bgkendall/piantor-remix/pcb/left/keyboard_pcb.kicad_pcb

## KiCad design pcb/left/keyboard_pcb.kicad_pcb (2024-06-12)

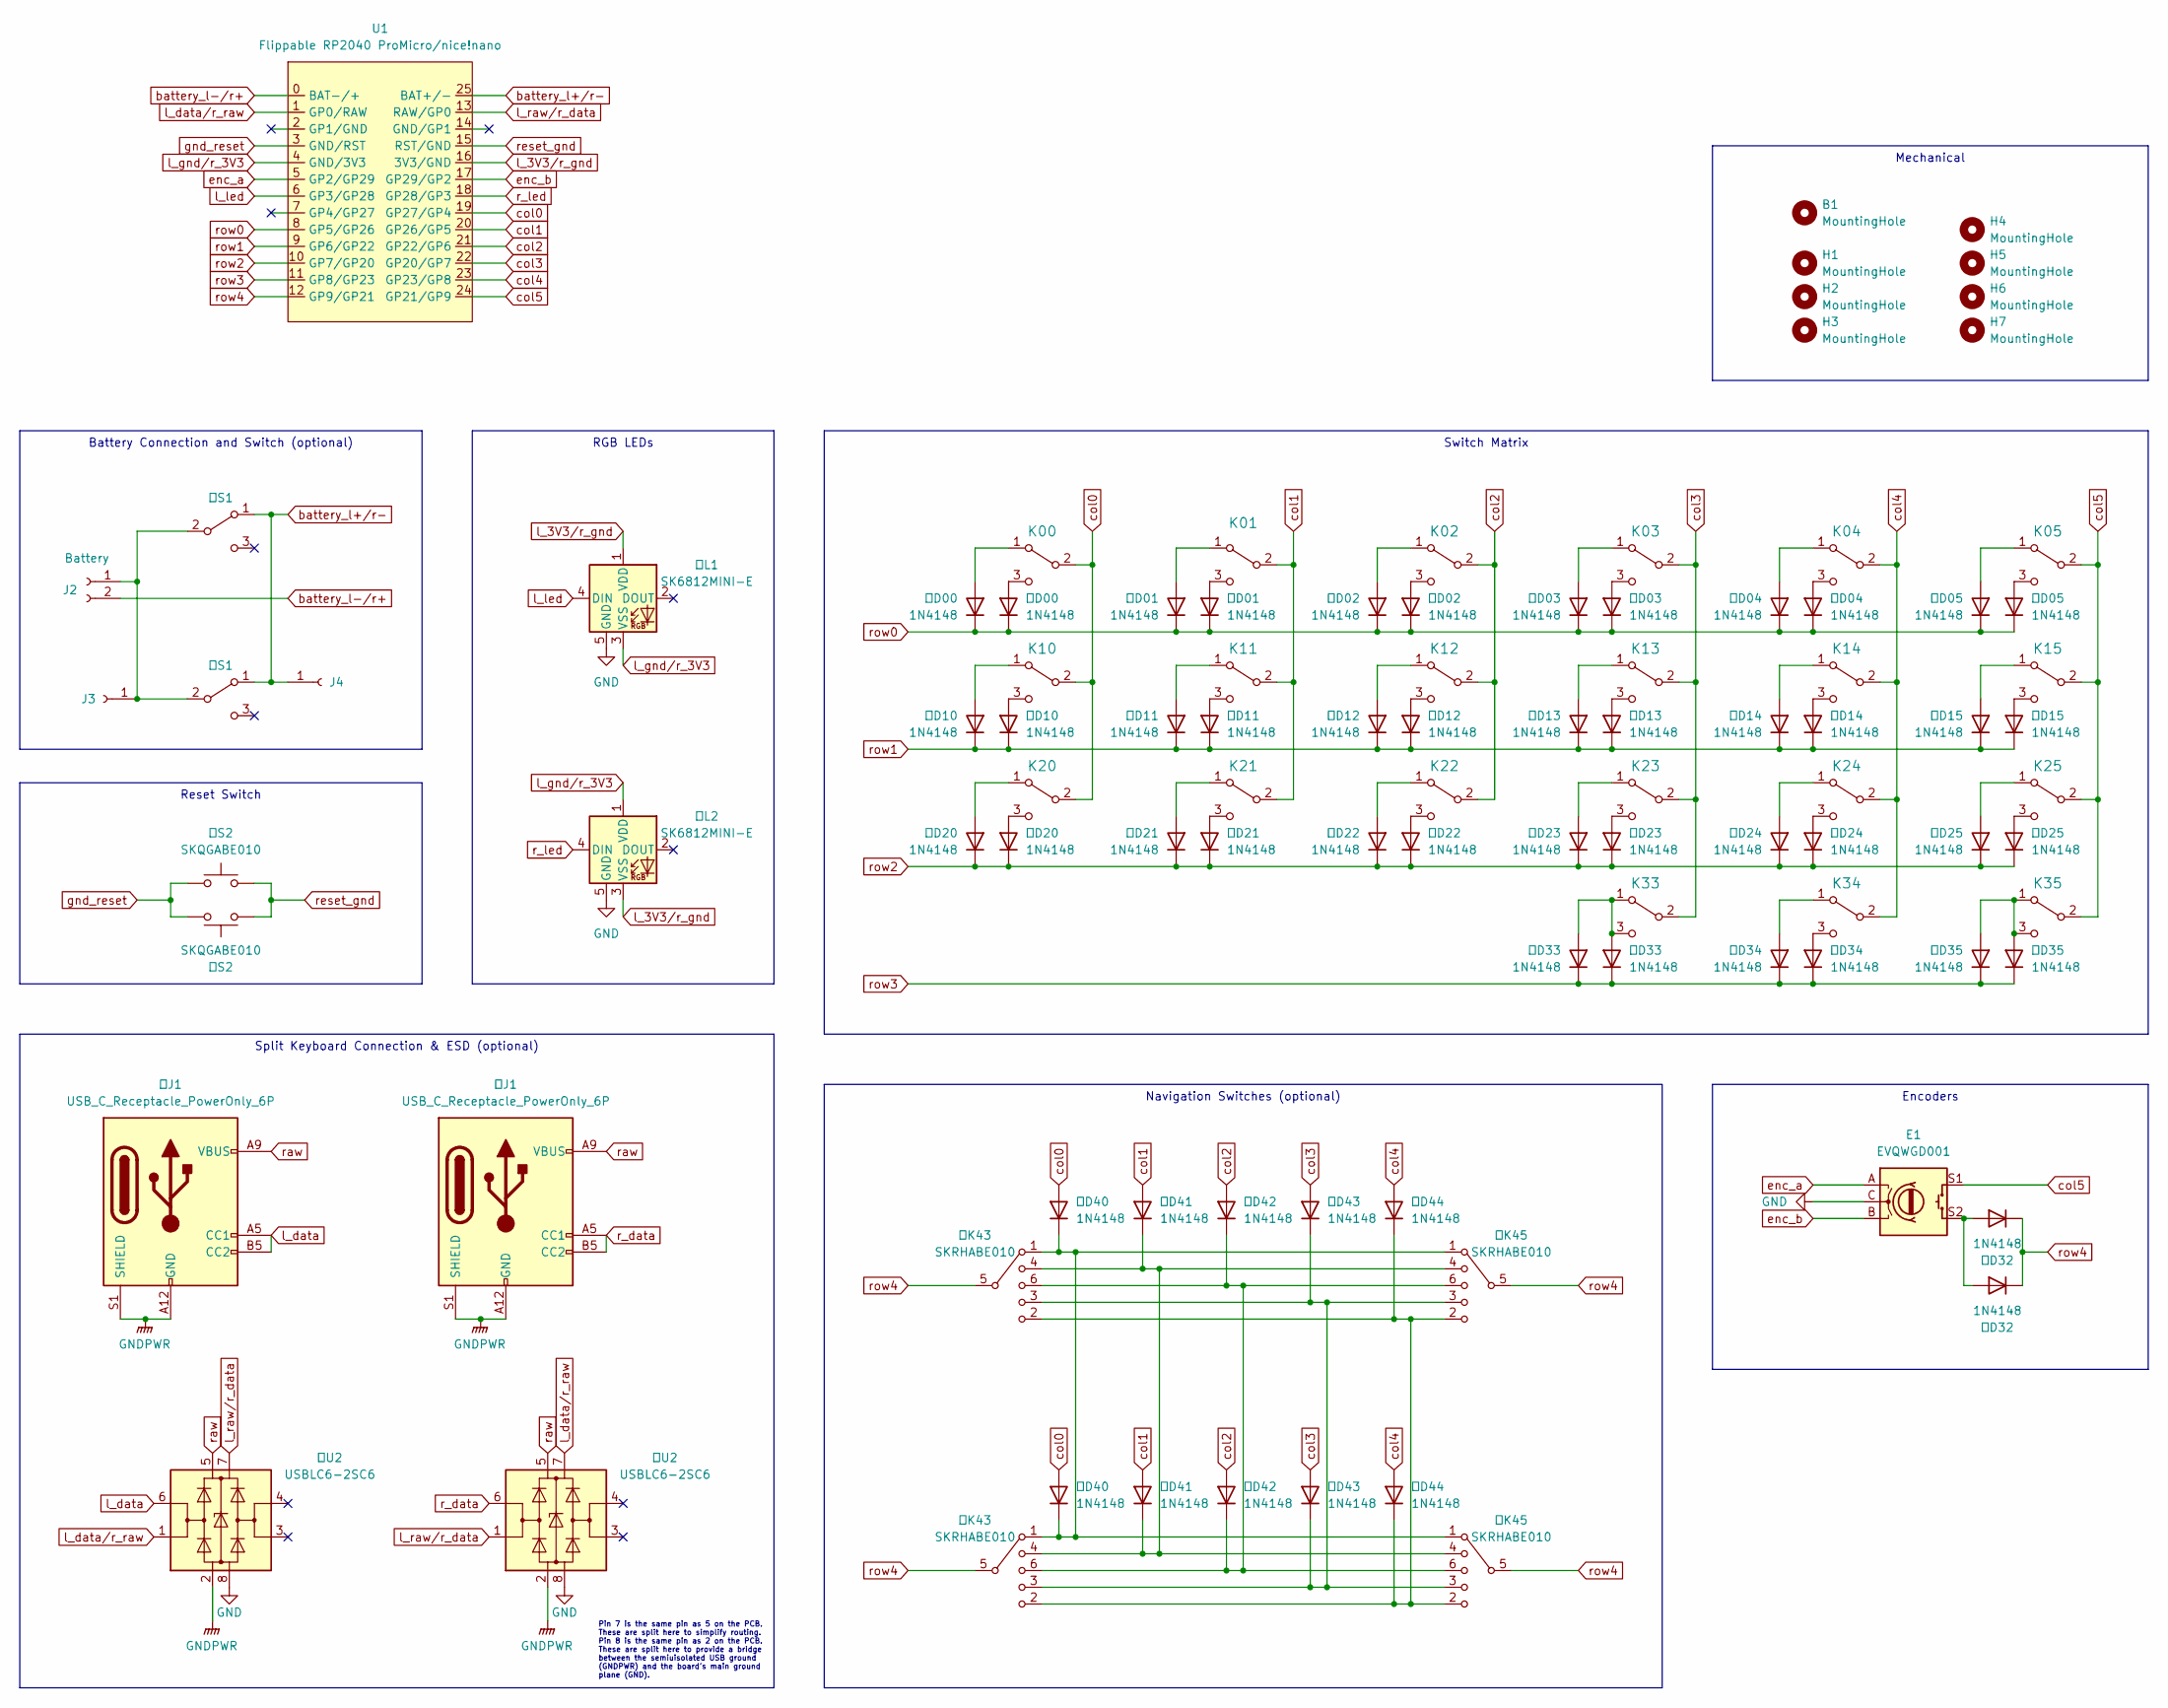
[picture p1: schematic keyboard_pcb.kicad_sch]

Parts:
B1: MountingHole; Battery_Cutout_401020
E1: EVQWGD001; RollerEncoder_Panasonic_EVQWGD001_Reversible
H1, H2, H3, H4, H5, H6, H7: MountingHole; MountingHole_2.2mm_M2
J2: Battery; SolderWire-0.127sqmm_1x02_P3.7mm_D0.48mm_OD1mm
J3, J4: Conn_01x01_Socket; SolderWire-0.127sqmm_1x01_D0.48mm_OD1mm
K00, K01, K10, K11, K20, K21: KEYSW; SW_choc_v1_HS_1u_Reversible_Opposing
K02, K03, K04, K05, K12, K13, K14, K15, K22, K23, K24, K25, K33, K34, K35: KEYSW; SW_choc_v1_HS_1u_Reversible
U1: Flippable RP2040 ProMicro/nice!nano; ProMicro_Battery_Reversible
右D00, 右D01, 右D02, 右D03, 右D04, 右D05, 右D10, 右D11, 右D12, 右D13, 右D14, 右D15, 右D20, 右D21, 右D22, 右D23, 右D24, 右D25, 右D32, 右D33, 右D34, 右D35: 1N4148; D_SOD-123; LCSC C7603179
右D40, 右D41, 右D42, 右D43, 右D44: 1N4148; D_SOD-123_Centre_Label; LCSC C7603179
右J1: USB_C_Receptacle_PowerOnly_6P; CUI_UJC-HP-L-G-5-MSMT-TR_Reversible_Optional; LCSC C2858274
右K43, 右K45: SKRHABE010; Nav_Switch_SKRHAxE010; LCSC C139794
右L2: SK6812MINI-E; SK6812-MINI-E_Jumped_GND
右S1: SW_SPST; SW_SPDT_PCM12_Reversible
右S2: SKQGABE010; SW_SPST_SKQG_WithStem; LCSC C115351
右U2: USBLC6-2SC6; SOT-23-6_Handsoldering_Split_VCC_GND
左D00, 左D01, 左D02, 左D03, 左D04, 左D05, 左D10, 左D11, 左D12, 左D13, 左D14, 左D15, 左D20, 左D21, 左D22, 左D23, 左D24, 左D25, 左D32, 左D33, 左D34, 左D35: 1N4148; D_SOD-123; LCSC C7603179
左D40, 左D41, 左D42, 左D43, 左D44: 1N4148; D_SOD-123_Centre_Label; LCSC C7603179
左J1: USB_C_Receptacle_PowerOnly_6P; CUI_UJC-HP-L-G-5-MSMT-TR_Reversible_Optional; LCSC C2858274
左K43, 左K45: SKRHABE010; Nav_Switch_SKRHAxE010; LCSC C139794
左L1: SK6812MINI-E; SK6812-MINI-E_Jumped_GND
左S1: SW_SPST; SW_SPDT_PCM12_Reversible
左S2: SKQGABE010; SW_SPST_SKQG_WithStem; LCSC C115351
左U2: USBLC6-2SC6; SOT-23-6_Handsoldering_Split_VCC_GND

Connections:
GND: E1.C, 右L2.5 (GND), 右U2.8 (GND_OUT), 左L1.5 (GND), 左U2.8 (GND_OUT)
GNDPWR: 右J1.A12 (GND), 右J1.B12 (GND), 右J1.S1 (SHIELD), 右U2.2 (GND_IN), 左J1.A12 (GND), 左J1.B12 (GND), 左J1.S1 (SHIELD), 左U2.2 (GND_IN)
unnamed: J2.1, J3.1, 右S1.2 (B), 左S1.2 (B)
unnamed: K00.1 (A), 左D00.2 (A)
unnamed: K00.3 (C), 右D00.2 (A)
unnamed: K01.1 (A), 左D01.2 (A)
unnamed: K01.3 (C), 右D01.2 (A)
unnamed: K02.1 (A), 左D02.2 (A)
unnamed: K02.3 (C), 右D02.2 (A)
unnamed: K03.1 (A), 左D03.2 (A)
unnamed: K03.3 (C), 右D03.2 (A)
unnamed: K04.1 (A), 左D04.2 (A)
unnamed: K04.3 (C), 右D04.2 (A)
unnamed: K05.1 (A), 左D05.2 (A)
unnamed: K05.3 (C), 右D05.2 (A)
unnamed: K10.1 (A), 左D10.2 (A)
unnamed: K10.3 (C), 右D10.2 (A)
unnamed: K11.1 (A), 左D11.2 (A)
unnamed: K11.3 (C), 右D11.2 (A)
unnamed: K12.1 (A), 左D12.2 (A)
unnamed: K12.3 (C), 右D12.2 (A)
unnamed: K13.1 (A), 左D13.2 (A)
unnamed: K13.3 (C), 右D13.2 (A)
unnamed: K14.1 (A), 左D14.2 (A)
unnamed: K14.3 (C), 右D14.2 (A)
unnamed: K15.1 (A), 左D15.2 (A)
unnamed: K15.3 (C), 右D15.2 (A)
unnamed: K20.1 (A), 左D20.2 (A)
unnamed: K20.3 (C), 右D20.2 (A)
unnamed: K21.1 (A), 左D21.2 (A)
unnamed: K21.3 (C), 右D21.2 (A)
unnamed: K22.1 (A), 左D22.2 (A)
unnamed: K22.3 (C), 右D22.2 (A)
unnamed: K23.1 (A), 左D23.2 (A)
unnamed: K23.3 (C), 右D23.2 (A)
unnamed: K24.1 (A), 左D24.2 (A)
unnamed: K24.3 (C), 右D24.2 (A)
unnamed: K25.1 (A), 左D25.2 (A)
unnamed: K25.3 (C), 右D25.2 (A)
unnamed: K33.1 (A), K33.3 (C), 右D33.2 (A), 左D33.2 (A)
unnamed: K34.1 (A), 左D34.2 (A)
unnamed: K34.3 (C), 右D34.2 (A)
unnamed: K35.1 (A), K35.3 (C), 右D35.2 (A), 左D35.2 (A)
unnamed: E1.S2, 右D32.2 (A), 左D32.2 (A)
unnamed: 右D40.1 (K), 右K43.1 (A), 右K45.1 (A), 左D40.1 (K), 左K43.1 (A), 左K45.1 (A)
unnamed: 右D41.1 (K), 右K43.4 (B), 右K45.4 (B), 左D41.1 (K), 左K43.4 (B), 左K45.4 (B)
unnamed: 右D42.1 (K), 右K43.6 (D), 右K45.6 (D), 左D42.1 (K), 左K43.6 (D), 左K45.6 (D)
unnamed: 右D43.1 (K), 右K43.3 (C), 右K45.3 (C), 左D43.1 (K), 左K43.3 (C), 左K45.3 (C)
unnamed: 右D44.1 (K), 右K43.2 (Ctr), 右K45.2 (Ctr), 左D44.1 (K), 左K43.2 (Ctr), 左K45.2 (Ctr)
battery_l+/r-: J4.1, U1.25 (BAT+/-), 右S1.1 (A), 左S1.1 (A)
battery_l-/r+: J2.2, U1.0 (BAT-/+)
col0: K00.2 (B), K10.2 (B), K20.2 (B), U1.19 (GP27/GP4), 右D40.2 (A), 左D40.2 (A)
col1: K01.2 (B), K11.2 (B), K21.2 (B), U1.20 (GP26/GP5), 右D41.2 (A), 左D41.2 (A)
col2: K02.2 (B), K12.2 (B), K22.2 (B), U1.21 (GP22/GP6), 右D42.2 (A), 左D42.2 (A)
col3: K03.2 (B), K13.2 (B), K23.2 (B), K33.2 (B), U1.22 (GP20/GP7), 右D43.2 (A), 左D43.2 (A)
col4: K04.2 (B), K14.2 (B), K24.2 (B), K34.2 (B), U1.23 (GP23/GP8), 右D44.2 (A), 左D44.2 (A)
col5: E1.S1, K05.2 (B), K15.2 (B), K25.2 (B), K35.2 (B), U1.24 (GP21/GP9)
enc_a: E1.A, U1.5 (GP2/GP29)
enc_b: E1.B, U1.17 (GP29/GP2)
gnd_reset: U1.3 (GND/RST), 右S2.2, 左S2.1
l_3V3/r_gnd: U1.16 (3V3/GND), 右L2.3 (VSS), 左L1.1 (VDD)
l_data: 左J1.A5 (CC1), 左J1.B5 (CC2), 左U2.6 (I/O1)
l_data/r_raw: U1.1 (GP0/RAW), 右U2.7 (VBUS_OUT), 左U2.1 (I/O1)
l_gnd/r_3V3: U1.4 (GND/3V3), 右L2.1 (VDD), 左L1.3 (VSS)
l_led: U1.6 (GP3/GP28), 左L1.4 (DIN)
l_raw/r_data: U1.13 (RAW/GP0), 右U2.1 (I/O1), 左U2.7 (VBUS_OUT)
r_data: 右J1.A5 (CC1), 右J1.B5 (CC2), 右U2.6 (I/O1)
r_led: U1.18 (GP28/GP3), 右L2.4 (DIN)
raw: 右J1.A9 (VBUS), 右J1.B9 (VBUS), 右U2.5 (VBUS_IN), 左J1.A9 (VBUS), 左J1.B9 (VBUS), 左U2.5 (VBUS_IN)
reset_gnd: U1.15 (RST/GND), 右S2.1, 左S2.2
row0: U1.8 (GP5/GP26), 右D00.1 (K), 右D01.1 (K), 右D02.1 (K), 右D03.1 (K), 右D04.1 (K), 右D05.1 (K), 左D00.1 (K), 左D01.1 (K), 左D02.1 (K), 左D03.1 (K), 左D04.1 (K), 左D05.1 (K)
row1: U1.9 (GP6/GP22), 右D10.1 (K), 右D11.1 (K), 右D12.1 (K), 右D13.1 (K), 右D14.1 (K), 右D15.1 (K), 左D10.1 (K), 左D11.1 (K), 左D12.1 (K), 左D13.1 (K), 左D14.1 (K), 左D15.1 (K)
row2: U1.10 (GP7/GP20), 右D20.1 (K), 右D21.1 (K), 右D22.1 (K), 右D23.1 (K), 右D24.1 (K), 右D25.1 (K), 左D20.1 (K), 左D21.1 (K), 左D22.1 (K), 左D23.1 (K), 左D24.1 (K), 左D25.1 (K)
row3: U1.11 (GP8/GP23), 右D33.1 (K), 右D34.1 (K), 右D35.1 (K), 左D33.1 (K), 左D34.1 (K), 左D35.1 (K)
row4: U1.12 (GP9/GP21), 右D32.1 (K), 右K43.5 (Com), 右K45.5 (Com), 左D32.1 (K), 左K43.5 (Com), 左K45.5 (Com)

Notes on the sheet:
Reset Switch
RGB LEDs
Encoders
Mechanical
Switch Matrix
Navigation Switches (optional)
Split Keyboard Connection & ESD (optional)
Battery Connection and Switch (optional)
Pin 7 is the same pin as 5 on the PCB. These are split here to simplify routing. Pin 8 is the same pin as 2 on the PCB. These are split here to provide a bridge between the semiuisolated USB ground (GNDPWR) and the board’s main ground plane (GND).

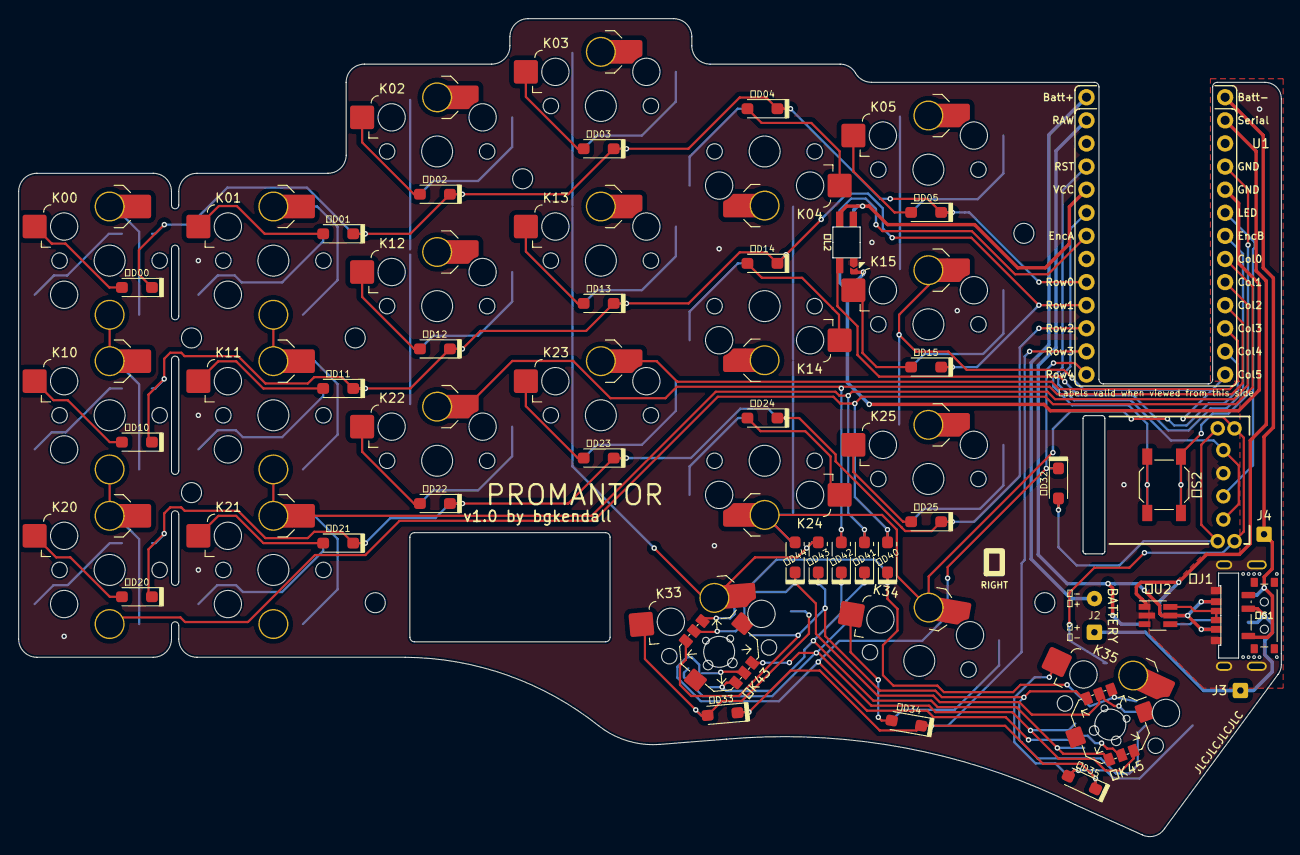
[picture p2: board keyboard_pcb.kicad_pcb from above]

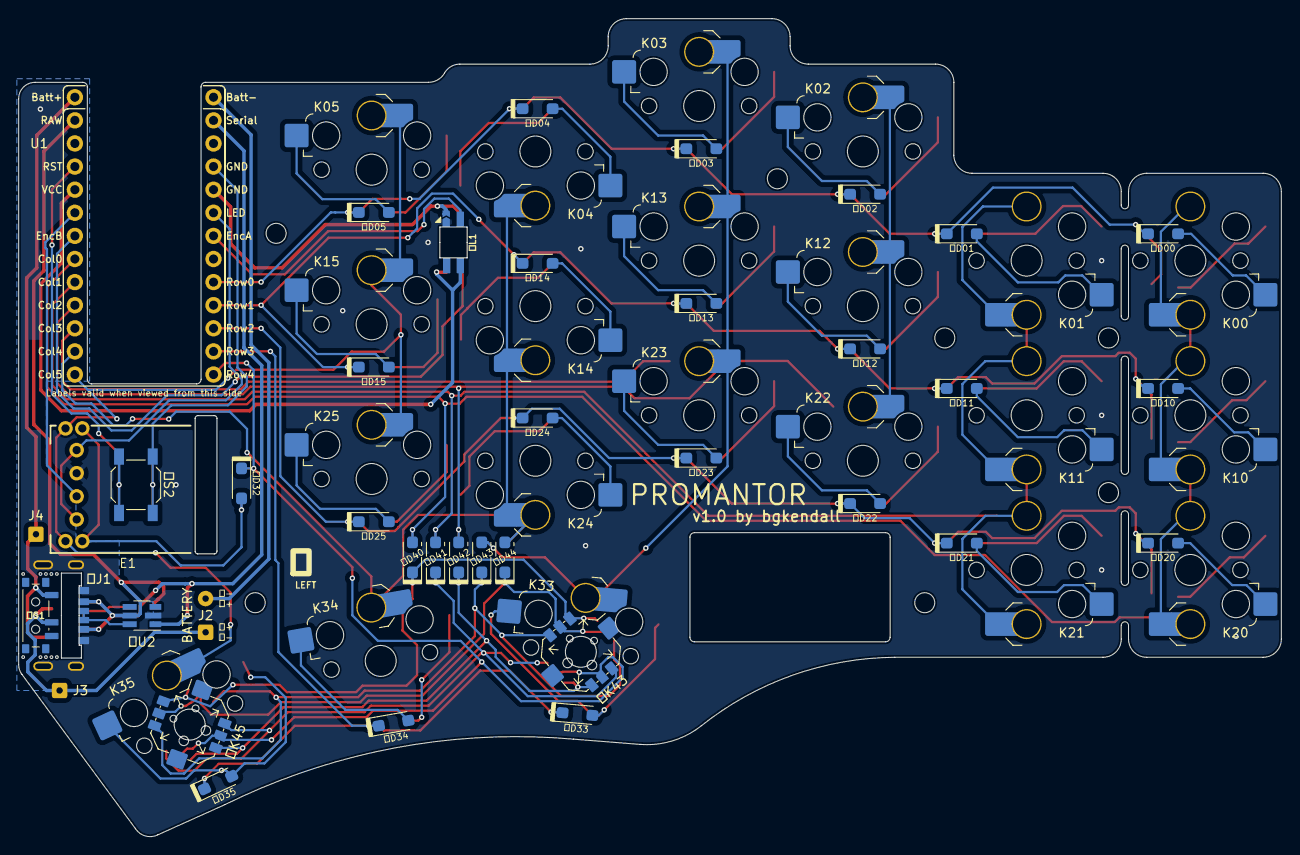
[picture p3: board keyboard_pcb.kicad_pcb from below]

Board: 2 copper layers, 138.8 x 89.9 mm, 102 parts (34 on the bottom side), 75 nets.
