bgkendall/piantor-remix/(commit log)

2024-02-09 Update files to KiCad 7
    [keyboard_pcb.kicad_pcb, keyboard_pcb.kicad_sch]
2024-02-09 Remove VBUS sense
    [keyboard_pcb.kicad_sch]
2024-02-09 Updated schematic
    * Replace Pico with Pro Micro
    * Copy ProMicro footprint from [marbastlib](https://github.com/ebastler/marbastlib) and update with flipped pin labels
    * Add battery connections
    * Add RGB LED
    * Add reset switch
    * Switch split keyboard connection from audio jack to USB C
    [keyboard_pcb.kicad_sch]
2024-02-09 Update matrix schematic
    * Add diodes
    * Add 5-way nav. switches
    * Duplicate left to right
    * Tidy layout
    [keyboard_pcb.kicad_sch]
2024-02-10 Update nav. switch symbol to match datasheet
    https://www.mouser.com/datasheet/2/15/SKRH-1370966.pdf
    [keyboard_pcb.kicad_sch]
2024-02-10 Add nav. switch footprint based on datasheet
    [SKRHAxE010](https://www.mouser.com/datasheet/2/15/SKRH-1370966.pdf)
2024-02-10 Tweak nav. switch footprint
2024-02-10 Add roller encoder footprint
    [rollyboi9000000](https://github.com/howardt12345/rollyboi9000000)
    See [note on pinout](https://github.com/rcuquemelle/EVQWGD001-Pinout/blob/main/README.md)
2024-02-10 Add slide switch footprint
    SW_MSK12C02 from [marbastlib](https://github.com/ebastler/marbastlib/blob/main/footprints/marbastlib-various.pretty/SW_MSK12C02-HB.kicad_mod)
    Right guide boss is removed to allow two switches to be placed on opposite sides of a PCB without duplicate drill holes
2024-02-10 Add 6-pin USB C socket footprint
    Copied from KiCad library
    Right mounting holes are removed to allow two socket footprints to be placed on opposite sides of a PCB without duplicate holes
2024-02-10 Add project’s Keebio Parts library
2024-02-10 Assign footprints
    TODO:
    * Reassign mounting holes — these seem to have been renamed, so the schematic no longer matches the linked library
    * Create mirrorable MCU footprint
    * Decide on reset switch
    * Create mirrorable hot-swap switch footprint(s)
    [keyboard_pcb.kicad_sch]
2024-02-10 Fix mounting holes
    There were two H1s and three H4s! Add H5–7 and assign M2 mounting hole from KiCad library (no visible change noticed when updating on PCB).
    [keyboard_pcb.kicad_pcb, keyboard_pcb.kicad_sch]
2024-02-10 Fix pin numbering for SK6812MINI-E
    The “E” has a different [pinout](https://cdn-shop.adafruit.com/product-files/4960/4960_SK6812MINI-E_REV02_EN.pdf) to the non-“E”
    [keyboard_pcb.kicad_sch]
2024-02-12 Tweak schematic
    * Change power switches to SP**D**T to match MSK12C02
    * Switch from double-named nets to single name that covers both orientations
    * Update flippable ProMicro symbol to remove gaps between pins that are no longer needed
    * Wire connection to ground through SK6812 GND leg, which will act as a jumper
    [keyboard_pcb.kicad_sch]
2024-02-13 Update battery connections, etc.
    * Add THT option for battery connection
    * Add THT option for external power switch
    * Rationalise circuit for battery connections and switches
    * Add mouse bites for switch panel
    * Use Molex Pico-EZmate connector for battery (other connectors are too tall)
    * Simplify circuit diagram for reset switch
    [keyboard_pcb.kicad_sch]
2024-02-13 Simplify keyboard matrix
    * Remove right-hand keys (left-hand keys will be made reversible)
    * Add right hand diodes into left-hand (now common) matrix
    * Move encoders into own group
    * Move navigation switches into own group
    * Swap encoder A and left LED pins on MCU (so that encoder pins are together), move right LED pin to be opposite left LED pin
    * Wire split keyboard ground pins to GND
    [keyboard_pcb.kicad_sch]
2024-02-13 Indicate diode type
    [keyboard_pcb.kicad_sch]
2024-02-13 Add bespoke diode footprint
    [keyboard_pcb.kicad_sch]
2024-02-13 Update names of project symbol and footprint libraries
    [keyboard_pcb.kicad_sch]
2024-02-13 Add descriptions to custom footprints and adjust arrows in nav. switch footprint
2024-02-13 Round corners of SK6812 footprint to match other footprints
2024-02-13 Add reversible hot-swap choc footprint
2024-02-13 Renumber thumb keys to match new schematic
    [keyboard_pcb.kicad_pcb]
2024-02-13 Rotate switch footprint to fit board
2024-02-13 Add alternate reversible switch footprint
2024-02-13 Tweak switch footprint
2024-02-13 Assign new switch footprints
    [keyboard_pcb.kicad_sch]
2024-02-13 Un-mirror switches
    [keyboard_pcb.kicad_sch]
2024-02-17 Use CUI Devices USB receptacle for board-to-board connection
    [Model UJC-HP-L-G-5-MSMT-TR](https://www.cuidevices.com/product/resource/ujc-hp-l-g-5-msmt-tr.pdf)
    [keyboard_pcb.kicad_sch]
2024-02-18 Base slide switch on KiCad library version
    [keyboard_pcb.kicad_sch]
2024-02-18 Assign reset button footprint and remove unneeded mouse-bite symbols
    [keyboard_pcb.kicad_sch]
2024-02-18 Change roller encoder to reversible version
    [keyboard_pcb.kicad_sch]
2024-02-18 Add battery cut-out
    [keyboard_pcb.kicad_sch]
2024-02-19 Tweak footprint for USB socket
    That location on the board will either have the mid-mount USB socket (wired boards) or the power switch (wireless boards). Since the mid-mount socket requires a cut-out but the switch does not, the socket cut-out is made optional using mouse-bites.
    [keyboard_pcb.kicad_sch]
2024-02-19 Fix minor issues and footprint assignments
    [keyboard_pcb.kicad_sch]
2024-02-19 Clean PCB
    * Remove all tracks and vias
    * Remove VBUS detect resistors
    [keyboard_pcb.kicad_pcb]
2024-02-19 Update PCB from schematic
    * Rotate switches as needed
    * Flip all lefthand footprints to back
    * Fix minor alignment issue in USB socket
    [keyboard_pcb.kicad_pcb]
2024-02-19 Position key switch diodes and nav. switches, tweak footprint silkscreens
    [keyboard_pcb.kicad_pcb]
2024-02-19 Make SK6812 footprint cut-out reversible
    Overlapping cut-outs do not seem to work, so each side now has just half the cut-out outline.
2024-02-19 Minor footprint tweaks
2024-02-19 Encoder B pin is now opposite Encoder A
    This should mean that the pins will actually work out the same when the board is flipped.
    [keyboard_pcb.kicad_sch]
2024-02-19 Replaced RP Pico with Pro Micro/nice!nano footprint
    For space reasons, the MCU will be mounted immediately under the main PCB (with no standoffs) with the USB port facing upwards. This requires a cut-out in the PCB to allow space for the USB port and other components.
    [keyboard_pcb.kicad_pcb, keyboard_pcb.kicad_sch]
2024-02-19 Fix 3D model location for switches
2024-02-19 Rough layout of all components, split switch jumper into two jumpers
    [keyboard_pcb.kicad_pcb, keyboard_pcb.kicad_sch]
2024-02-19 Prevent switch labels from being covered by hot-swap socket
2024-02-20 Fillet battery cut-out
2024-02-20 Add outlines of Piantor and Piantor Pro cases and align USB ports as needed
    [keyboard_pcb.kicad_pcb]
2024-02-20 Various tweaks
    * Assign `PWR` net class to battery connections
    * Change `PWR` net class witch to 3.8mm for more routing options around USB ports and power switch
    * Renumber sockets so that the USB ports are ×J1, and the power connections start at J2
    * Remove the switch access point that is duplicated by pin 1 of the alternate battery connection
    * Change reset switch to the smaller B3U-1000P-B (this may change again as that one is a bit pricey for a reset switch)
    * Move reset switch to be near reset pin
    * Move power inputs to be nearer power switch
    * Rotate encoder 180º and move to 3.6mm from edge and as close to USB socket as possible while still allowing at least one connection th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
    [keyboard_pcb.kicad_pcb, keyboard_pcb.kicad_sch]
2024-02-20 Assign “battery_l+/r-” to PWT net class
2024-02-20 Adjust silkscreen on ProMicro footprint
2024-02-20 Make USB port GND connections solid
2024-02-20 Add net class flag to “battery_l+/r-”
    [keyboard_pcb.kicad_sch]
2024-02-20 Add tracks for power and related nets, update footprints
    [keyboard_pcb.kicad_pcb]
2024-02-20 Rotate nav. switches so that pins 4–6 are not right next to a hot-swap pad on the same side
    [keyboard_pcb.kicad_pcb]
2024-02-20 Connect encoder to MCU, separate left and right side encoder switch to diode connection
    [keyboard_pcb.kicad_pcb, keyboard_pcb.kicad_sch]
2024-02-20 Add tracks connecting rows and columns to MCU, swap LED and Encoder pins for ease of routing
    [keyboard_pcb.kicad_pcb, keyboard_pcb.kicad_sch]
2024-02-20 Further routing tweaks
    [keyboard_pcb.kicad_pcb]
2024-02-21 Tweak orientation of nav. switches and put them on the correct side
    [keyboard_pcb.kicad_pcb]
2024-02-21 Connect left and right nav. switch nets to allow for easier routing
    [keyboard_pcb.kicad_sch]
2024-02-21 Initial routing of nav. switches
    [keyboard_pcb.kicad_pcb]
2024-02-21 Move encoder diode outside encoder footprint
    Want to add a standoff under the encoder, so can’t have a component there!
    Updated schematic between encoder and diode to simplify routing.
    [keyboard_pcb.kicad_pcb, keyboard_pcb.kicad_sch]
2024-02-21 Connected columns
    [keyboard_pcb.kicad_pcb]
2024-02-21 Connect rows
    [keyboard_pcb.kicad_pcb]
2024-02-21 Remove mouse bites
    [keyboard_pcb.kicad_pcb, keyboard_pcb.kicad_sch]
2024-02-21 Minor routing tweaks
    [keyboard_pcb.kicad_pcb]
2024-02-21 Clean up a few DRC errers
    [keyboard_pcb.kicad_pcb]
2024-02-21 Update switch footprints to remove courtyard errors from DRC
    [keyboard_pcb.kicad_pcb]
2024-02-21 Fix silkscreen warnings reported by DRC
    [keyboard_pcb.kicad_pcb, keyboard_pcb.kicad_sch]
2024-02-21 Update reversible hot-swap footprint to wrap pad around hole rather than colliding
    [keyboard_pcb.kicad_pcb]
2024-02-22 Reduce size of MCU keep-out, fit silkscreen issues
    [keyboard_pcb.kicad_pcb, keyboard_pcb.kicad_sch]
2024-02-22 Update matrix to remove missing connections
    The switch side of lefthand diodes no longer need to connect righthand diodes. Diodes join to the same row trace, but the switch-to-diode connections are separate (except for the switches that overlap with nav. switches — these are joined to reduct routes). The switches in the schematic are now represented as SPDT switches, which have two outputs instead of one. The footprints have been updated to number the righthand side leg to pin 3 (instead of being another pin 1).
    [keyboard_pcb.kicad_pcb, keyboard_pcb.kicad_sch]
2024-02-22 Fix ground plane and some minor changes
    * Add vias to fix all ground plane disconnects reported by DRC
    * Change reset switch part
    * Add reference to backside of encoder
    * Fix broken line on encoder silkscreen
    * Fix footprint type for SK6812-MINI-E
    [keyboard_pcb.kicad_pcb, keyboard_pcb.kicad_sch]
2024-02-23 Minor tweaks
    * Improve ground plane
    * Improve SK6812 jumper pin
    * Add silkscreen enclosing bottom 12 pins of MCU
    [keyboard_pcb.kicad_pcb]
2024-02-23 Tweak routing
    Also, ensure that ground planes are connected if outer column removed
    [keyboard_pcb.kicad_pcb]
2024-02-25 Update some silkscreening and a minor routing tweak
    [keyboard_pcb.kicad_pcb]
2024-02-25 Change footprints for wire connections
    [keyboard_pcb.kicad_pcb, keyboard_pcb.kicad_sch]
2024-02-25 Add version silkscreen
    [keyboard_pcb.kicad_pcb]
2024-02-25 Fix track positions undone by previous change
    [keyboard_pcb.kicad_pcb]
2024-02-25 Add alt. battery socket and JLC order number silkscreens
    [keyboard_pcb.kicad_pcb]
2024-03-26 Update track routing
    [keyboard_pcb.kicad_pcb]
2024-04-07 Add non-optional (reversible only) version of mid-mount USB C socket
2024-04-07 Change shield pins to match schematic symbol
2024-05-05 Part updates
    * Add LCSC part number property to various parts
    * Update Value for various parts
    * Use SKQGABE010 for reset instead of KXT3
    * Move reset switches to under encoder to accommodate larger switch footprint
    * Re-route reset tracks and some nearby tracks
    * Tweak silkscreens
    * Tweak various routings
    [keyboard_pcb.kicad_pcb, keyboard_pcb.kicad_sch]
2024-05-05 Remove Pico-EZmate connector for battery
    The battery terminals can be (carefully) soldered to the board. This is going to be far easier (and cheaper!) than trying to crimp the EZmate terminals (at least without the correct tools).
    [keyboard_pcb.kicad_pcb, keyboard_pcb.kicad_sch]
2024-05-11 Fix various DRC errors
    [keyboard_pcb.kicad_pcb]
2024-05-11 Add ESD protection to USB port
    A pair (left and right) of USBLC6 chips have been added. The USB port now has its own ground plane that is somewhat isolated from the main board ground and only connected at the USBLC6 ground pads.
    [keyboard_pcb.kicad_pcb, keyboard_pcb.kicad_sch]
2024-06-12 Update to KiCad v8
    [keyboard_pcb.kicad_pcb, keyboard_pcb.kicad_sch]
